techstudio-design/sim7080_dev_board/bom/PCB_3D.png

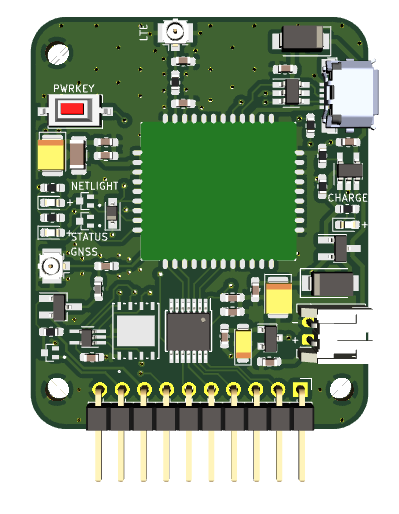
bom/PCB_3D.png
