techstudio-design/sim7080_dev_board/SIM7080_module.sch

## KiCad design SIM7080_module.sch (2021-09-07)

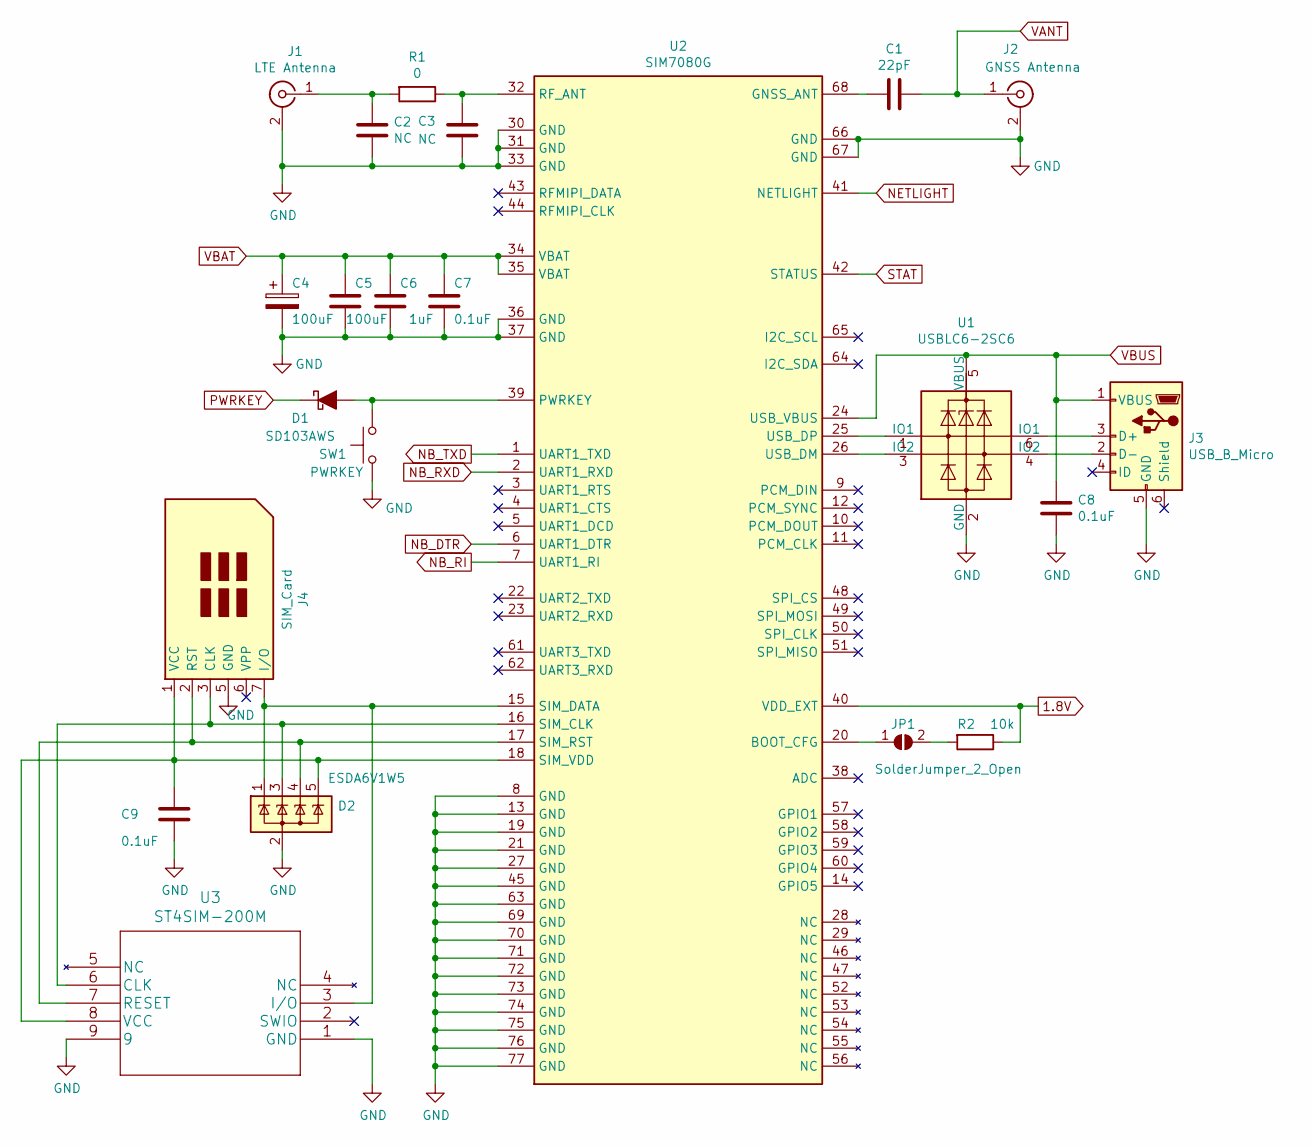
[picture p5: schematic SIM7080_module.sch]

Parts:
C1: 22pF; C_0603_1608Metric_Pad1.05x0.95mm_HandSolder
C2, C3: NC; C_0603_1608Metric_Pad1.05x0.95mm_HandSolder
C4: 100uF; CP_EIA-3528-12_Kemet-T_Pad1.50x2.35mm_HandSolder
C5: 100uF; C_1206_3216Metric_Pad1.42x1.75mm_HandSolder
C6: 1uF; C_0603_1608Metric_Pad1.05x0.95mm_HandSolder
C7, C8, C9: 0.1uF; C_0603_1608Metric_Pad1.05x0.95mm_HandSolder
D1: SD103AWS; D_SOD-323_HandSoldering
D2: ESDA6V1W5; SOT-353_SC-70-5_Handsoldering
J1: LTE Antenna; U.FL_Hirose_U.FL-R-SMT-1_Vertical
J2: GNSS Antenna; U.FL_Hirose_U.FL-R-SMT-1_Vertical
J3: USB_B_Micro; U254-051T-4BH83
J4: SIM_Card; HOAUC-HYC240-SIM-06-150_C645501
JP1: SolderJumper_2_Open; SolderJumper-2_P1.3mm_Open_Pad1.0x1.5mm
R1: 0; R_0603_1608Metric_Pad1.05x0.95mm_HandSolder
R2: 10k; R_0603_1608Metric_Pad1.05x0.95mm_HandSolder
SW1: PWRKEY; SW_TS-1101-X-X
U1: USBLC6-2SC6; SOT-23-6_Handsoldering
U2: SIM7080G
U3: ST4SIM-200M

Connections:
1.8V: R2.1, U2.40 (VDD_EXT)
GND: C2.2, C3.2, C4.2, C5.2, C6.2, C7.2, C8.2, C9.2, D2.2 (A), J1.2 (Ext), J2.2 (Ext), J3.5 (GND), J4.5 (GND), SW1.1, U1.2 (GND), U2.8 (GND), U2.13 (GND), U2.19 (GND), U2.21 (GND), U2.27 (GND), U2.30 (GND), U2.31 (GND), U2.33 (GND), U2.36 (GND), U2.37 (GND), U2.45 (GND), U2.63 (GND), U2.66 (GND), U2.67 (GND), U2.69 (GND), U2.70 (GND), U2.71 (GND), U2.72 (GND), U2.73 (GND), U2.74 (GND), U2.75 (GND), U2.76 (GND), U2.77 (GND), U3.1 (GND), U3.9
NB_DTR: U2.6 (UART1_DTR)
NB_RI: U2.7 (UART1_RI)
NB_RXD: U2.2 (UART1_RXD)
NB_TXD: U2.1 (UART1_TXD)
NETLIGHT: U2.41 (NETLIGHT)
unnamed: C1.1, U2.68 (GNSS_ANT)
unnamed: C2.1, J1.1 (In), R1.2
unnamed: C3.1, R1.1, U2.32 (RF_ANT)
unnamed: C9.1, D2.5 (K), J4.1 (VCC), U2.18 (SIM_VDD), U3.8 (VCC)
unnamed: D1.2 (A), SW1.2, U2.39 (PWRKEY)
unnamed: D2.1 (K), J4.7 (I/O), U2.15 (SIM_DATA), U3.3 (I/O)
unnamed: D2.3 (K), J4.3 (CLK), U2.16 (SIM_CLK), U3.6 (CLK)
unnamed: D2.4 (K), J4.2 (RST), U2.17 (SIM_RST), U3.7 (RESET)
unnamed: J3.2 (D-), U1.4 (IO2)
unnamed: J3.3 (D+), U1.6 (IO1)
unnamed: JP1.1 (A), U2.20 (BOOT_CFG)
unnamed: JP1.2 (B), R2.2
unnamed: U1.1 (IO1), U2.25 (USB_DP)
unnamed: U1.3 (IO2), U2.26 (USB_DM)
PWRKEY: D1.1 (K)
STAT: U2.42 (STATUS)
VANT: C1.2, J2.1 (In)
VBAT: C4.1, C5.1, C6.1, C7.1, U2.34 (VBAT), U2.35 (VBAT)
VBUS: C8.1, J3.1 (VBUS), U1.5 (VBUS), U2.24 (USB_VBUS)
