techstudio-design/sim7080_dev_board/SIM7080_peripherals.sch

## KiCad design SIM7080_peripherals.sch (2021-09-07)

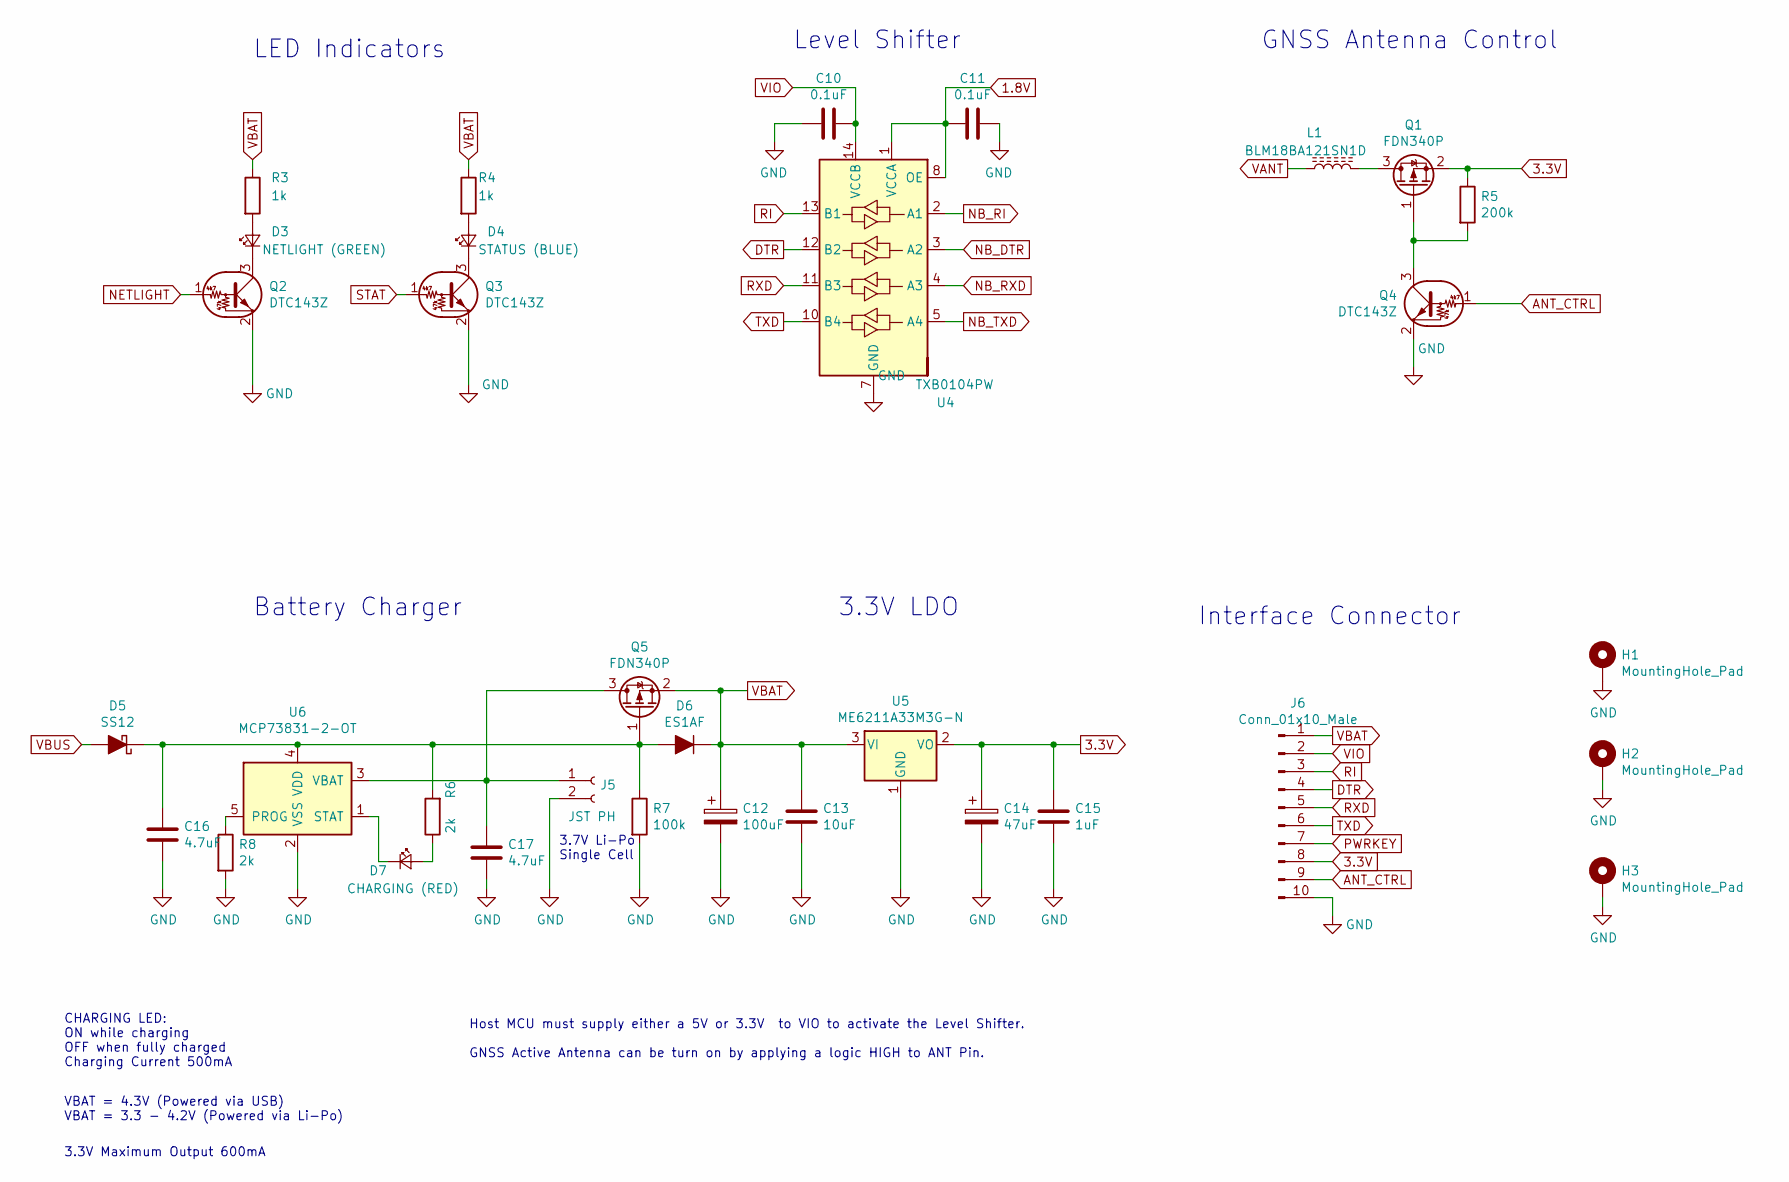
[picture p6: schematic SIM7080_peripherals.sch]

Parts:
C10, C11: 0.1uF; C_0603_1608Metric_Pad1.05x0.95mm_HandSolder
C12: 100uF; CP_EIA-3528-12_Kemet-T_Pad1.50x2.35mm_HandSolder
C13: 10uF; C_0603_1608Metric_Pad1.05x0.95mm_HandSolder
C14: 47uF; CP_EIA-3216-10_Kemet-I_Pad1.58x1.35mm_HandSolder
C15: 1uF; C_0603_1608Metric_Pad1.05x0.95mm_HandSolder
C16, C17: 4.7uF; C_0603_1608Metric_Pad1.05x0.95mm_HandSolder
D3: NETLIGHT (GREEN); LED_0603_1608Metric_Pad1.05x0.95mm_HandSolder
D4: STATUS (BLUE); LED_0603_1608Metric_Pad1.05x0.95mm_HandSolder
D5: SS12; D_SMA
D6: ES1AF; D_SMA
D7: CHARGING (RED); LED_0603_1608Metric_Pad1.05x0.95mm_HandSolder
H1, H2, H3: MountingHole_Pad; MountingHole_2.7mm_M2.5
J5: JST PH; JST_PH_S2B-PH-K_1x02_P2.00mm_Horizontal
J6: Conn_01x10_Male; PinHeader_1x10_P2.54mm_Horizontal
L1: BLM18BA121SN1D; L_0603_1608Metric_Pad1.05x0.95mm_HandSolder
Q1, Q5: FDN340P; SOT-23_Handsoldering
Q2, Q3, Q4: DTC143Z; SOT523
R3, R4: 1k; R_0603_1608Metric_Pad1.05x0.95mm_HandSolder
R5: 200k; R_0603_1608Metric_Pad1.05x0.95mm_HandSolder
R6, R8: 2k; R_0603_1608Metric_Pad1.05x0.95mm_HandSolder
R7: 100k; R_0603_1608Metric_Pad1.05x0.95mm_HandSolder
U4: TXB0104PW; TSSOP-14_4.4x5mm_P0.65mm
U5: ME6211A33M3G-N; SOT-23
U6: MCP73831-2-OT; SOT-23-5_HandSoldering

Connections:
1.8V: C11.2, U4.1 (VCCA), U4.8 (OE)
3.3V: C14.1, C15.1, J6.8, Q1.2 (S), R5.1, U5.2 (VO)
ANT_CTRL: J6.9, Q4.1 (B)
DTR: J6.4, U4.12 (B2)
GND: C10.2, C11.1, C12.2, C13.2, C14.2, C15.2, C16.2, C17.2, H1.1, H2.1, H3.1, J5.2, J6.10, Q2.2 (E), Q3.2 (E), Q4.2 (E), R7.2, R8.2, U4.7 (GND), U5.1 (GND), U6.2 (VSS)
NB_DTR: U4.3 (A2)
NB_RI: U4.2 (A1)
NB_RXD: U4.4 (A3)
NB_TXD: U4.5 (A4)
NETLIGHT: Q2.1 (B)
unnamed: C16.1, D5.1 (K), D6.2 (A), Q5.1 (G), R6.2, R7.1, U6.4 (VDD)
unnamed: C17.1, J5.1, Q5.3 (D), U6.3 (VBAT)
unnamed: D3.1 (K), Q2.3 (C)
unnamed: D3.2 (A), R3.2
unnamed: D4.1 (K), Q3.3 (C)
unnamed: D4.2 (A), R4.2
unnamed: D7.1 (K), U6.1 (STAT)
unnamed: D7.2 (A), R6.1
unnamed: L1.2, Q1.3 (D)
unnamed: Q1.1 (G), Q4.3 (C), R5.2
unnamed: R8.1, U6.5 (PROG)
PWRKEY: J6.7
RI: J6.3, U4.13 (B1)
RXD: J6.5, U4.11 (B3)
STAT: Q3.1 (B)
TXD: J6.6, U4.10 (B4)
VANT: L1.1
VBAT: C12.1, C13.1, D6.1 (K), J6.1, Q5.2 (S), R3.1, R4.1, U5.3 (VI)
VBUS: D5.2 (A)
VIO: C10.1, J6.2, U4.14 (VCCB)

Notes on the sheet:
3.7V Li-Po Single Cell
LED Indicators
Interface Connector
Level Shifter
Battery Charger
GNSS Antenna Control
3.3V LDO
3.3V Maximum Output 600mA
CHARGING LED: ON while charging OFF when fully charged Charging Current 500mA
VBAT = 4.3V (Powered via USB) VBAT = 3.3 - 4.2V (Powered via Li-Po)
Host MCU must supply either a 5V or 3.3V to VIO to activate the Level Shifter. GNSS Active Antenna can be turn on by applying a logic HIGH to ANT Pin.
