techstudio-design/sim7080_dev_board/(notices)

Notices in the files:
SIM7080_peripherals.sch:
Copyright: Tech Studio Design, 2021
